sonaliNautiyal/Temperature-Logger-IoT/documents/program explained/Program flow.pptx

## Program

Explain

## Flow Chart

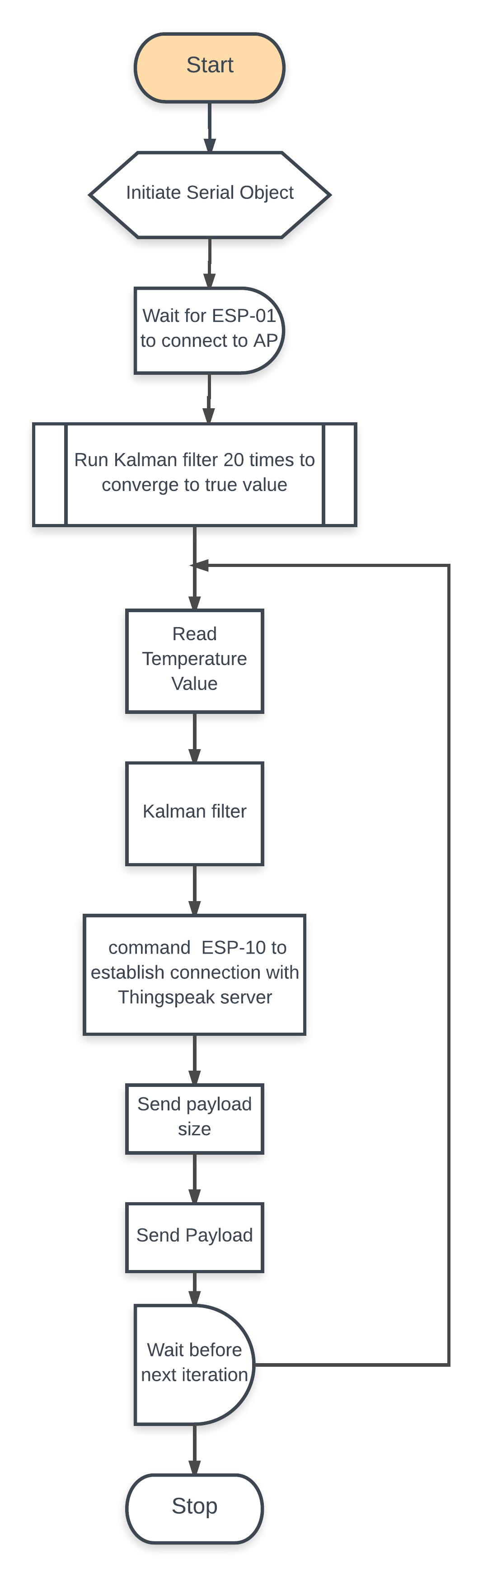
[picture p1: figure]

## Code

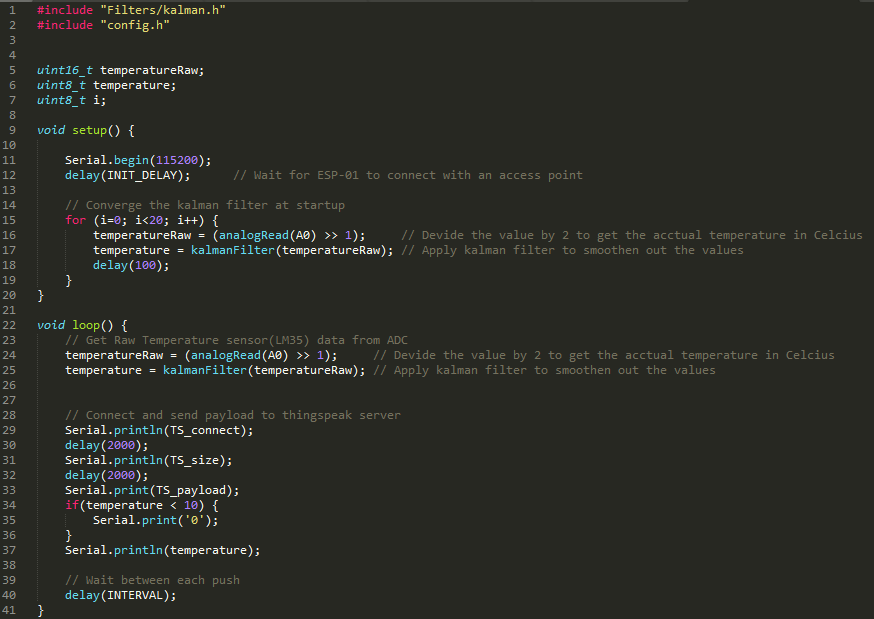
[picture p2: figure]

## config.h

Establish Connection with
Thingspeak Server

Payload without the temp. value

Declare Payload size (i.e. 74 bytes)

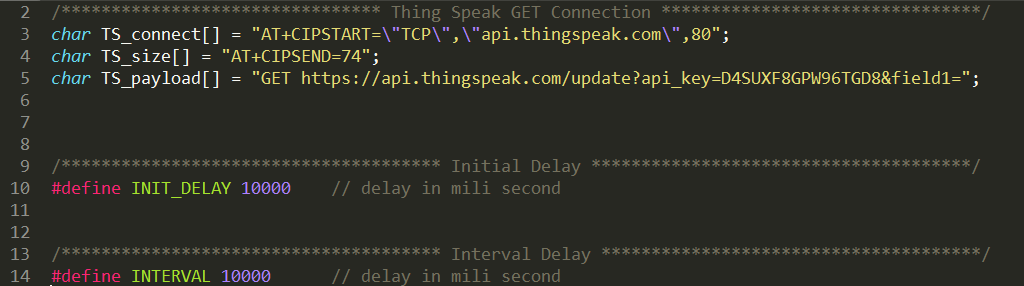
[picture p3: figure]

Chanel Key
