sonaliNautiyal/Temperature-Logger-IoT/documents/report/Report - IoT Temperature Sensor.pdf

## IoT Temperature Sensor

The aim was to design a device that can sense temperature of the environment and can periodically upload temperature data to a server on a cloud.

Few features of the device should be:

- Small
- Powered with lithium polymer cell
- Energy efficient
- WiFi Enabled

Components Used:

- TP4056 Module for LIPO battery charging and protection
- ATmega328P – AU (TQFP package for smaller size)
- Boost Converter of 5VDC output
- AMS1117 IC (3.3V linier voltage regulator for WiFi module)
- ESP-01 (ESP8266 based WiFi module)
- LM35 – Temperature sensor
- Lithium Polymer battery (1s)

Schematic Design (In Eagle PCB):

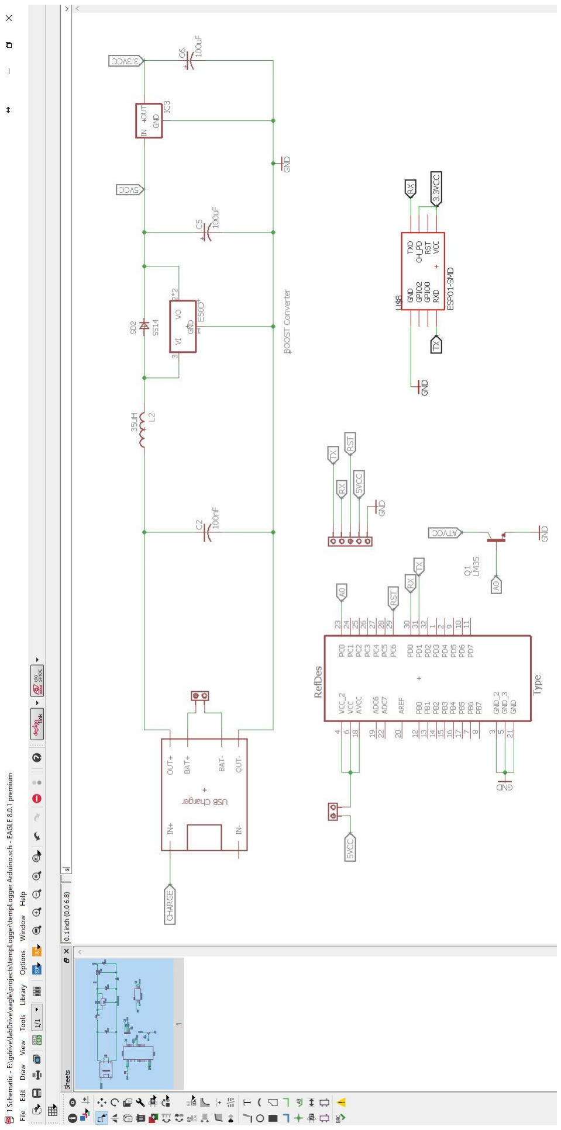
[picture p4: figure]
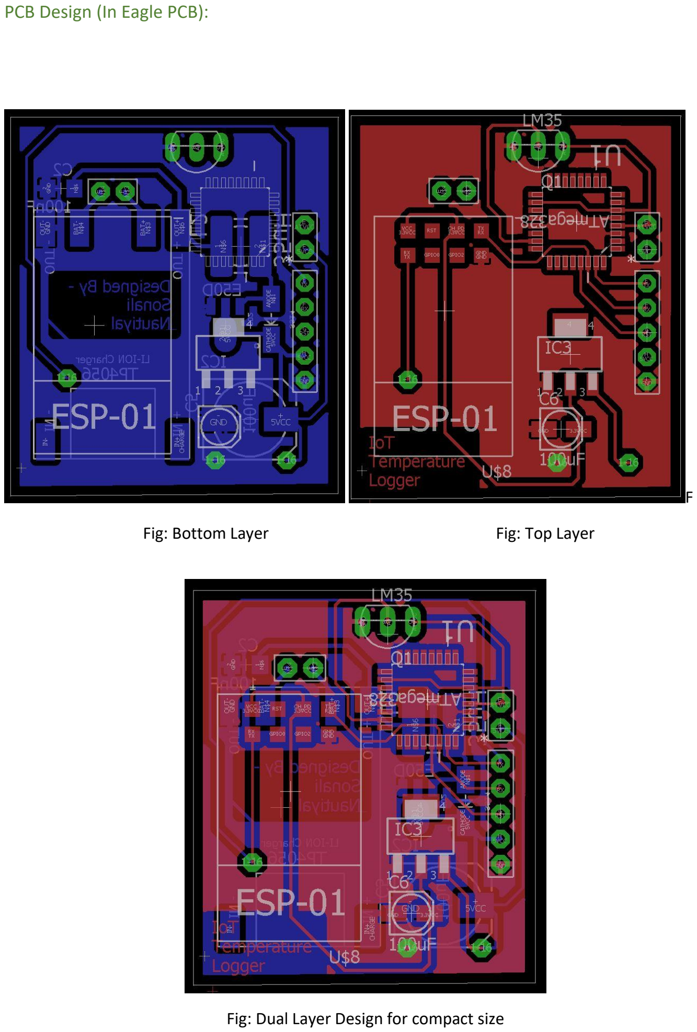
[picture p5: page 3]

PCB Design (In Eagle PCB):

F

Fig: Bottom Layer | Fig: Top Layer

Fig: Dual Layer Design for compact size

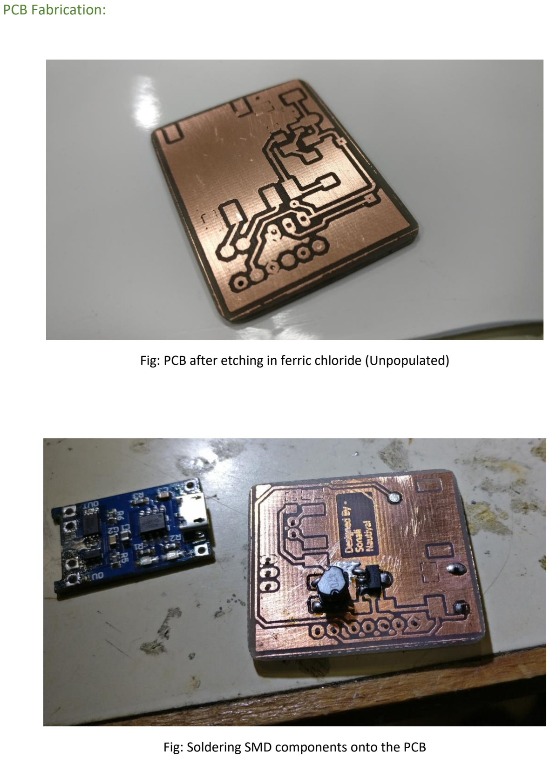
[picture p6: page 4]

PCB Fabrication:

Fig: PCB after etching in ferric chloride (Unpopulated)

Fig: Soldering SMD components onto the PCB

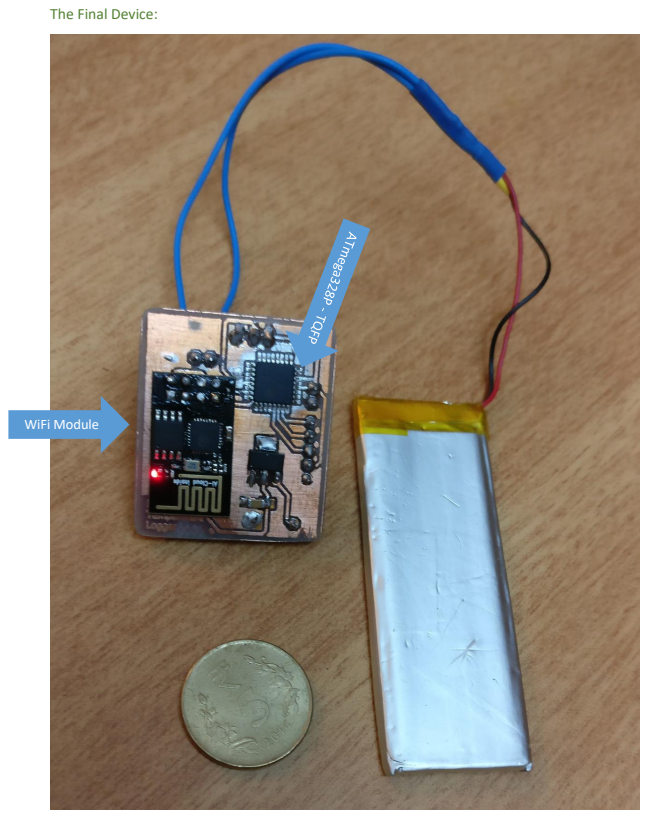
[picture p7: page 5]
WiFi Module

The Final Device:

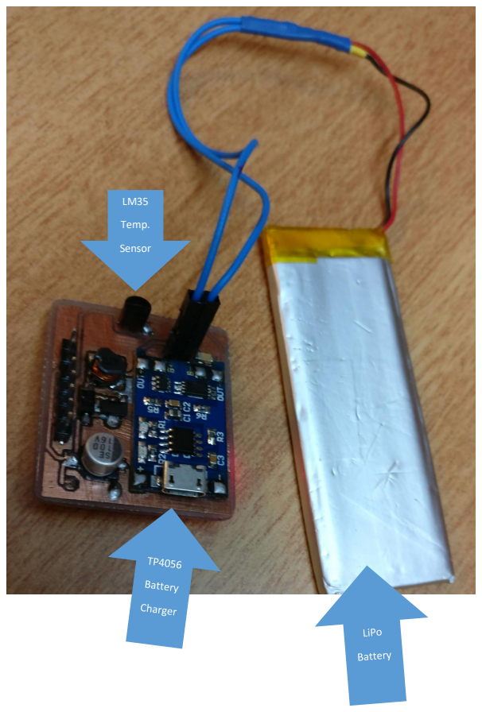
[picture p8: page 6]
Temp.; Sensor

Could Access:

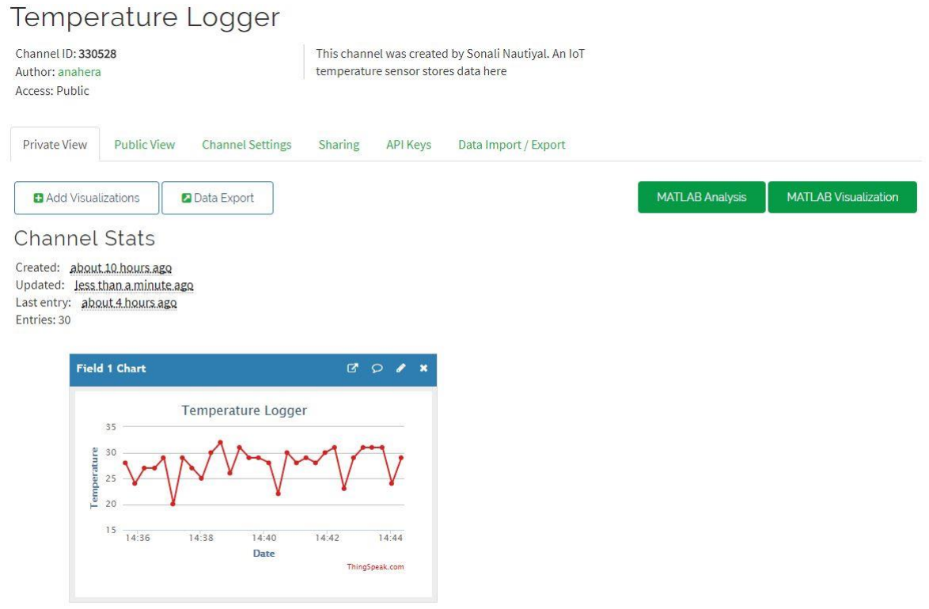
[picture p9: figure]

Fig: Accessing real-time temperature data stored in could server

Public Access Link:

## https://thingspeak.com/channels/330528
