sonaliNautiyal/Temperature-Logger-IoT/documents/dependency/ESP 8266.pdf

# ESP 8266

Setup

The chip

- ESP 8266 is the most common wifi chip there is
- There are multiple boards that use ESP chips and are as follows

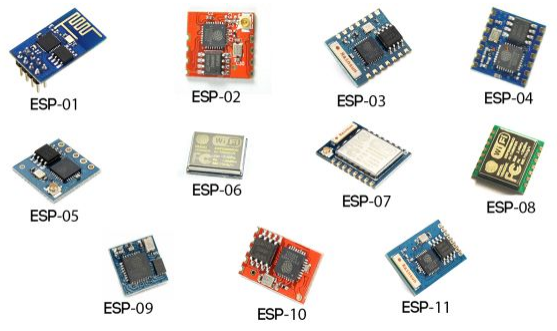
[picture p10: figure]

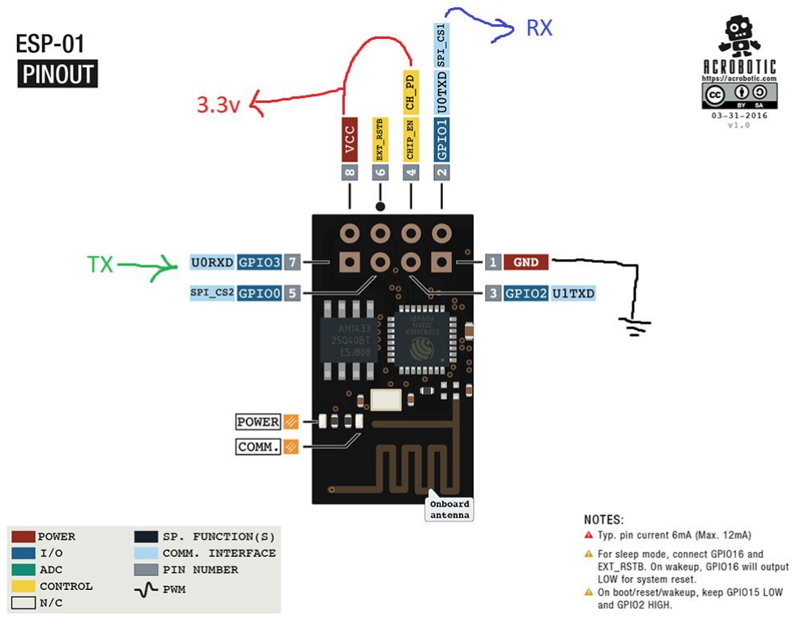
[picture p11: figure]

Pinout and Connections

AT commands in Serial Monitor

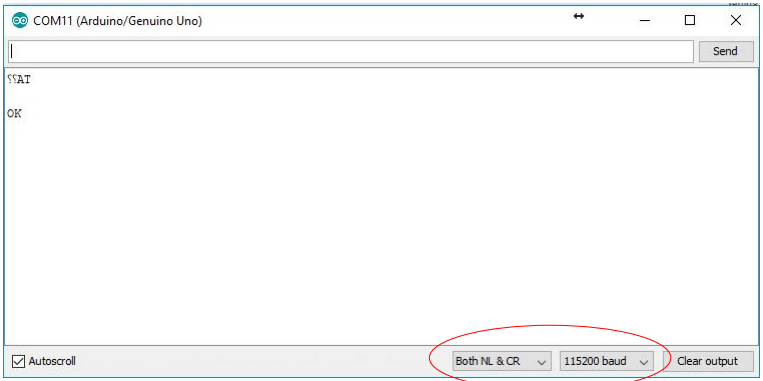
[picture p12: figure]
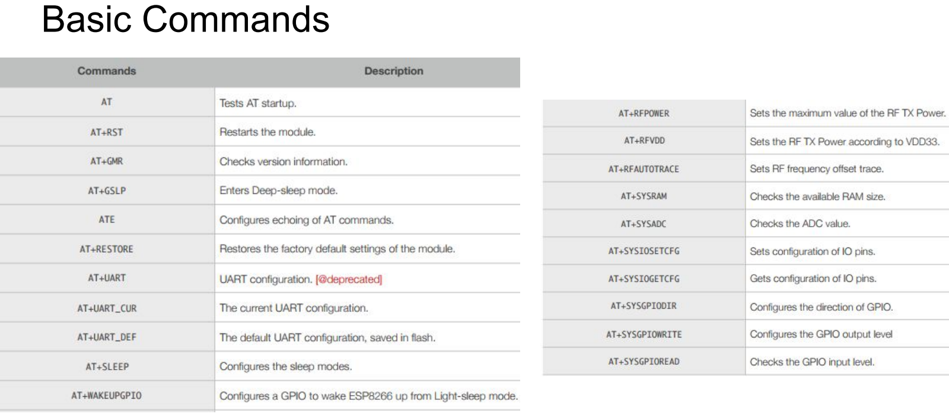
[picture p13: page 5]

Basic Commands

WiFi Commands

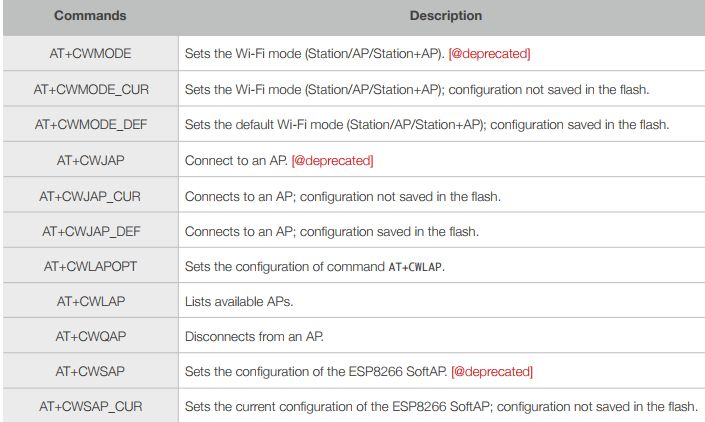
[picture p14: figure]

WiFi Commands

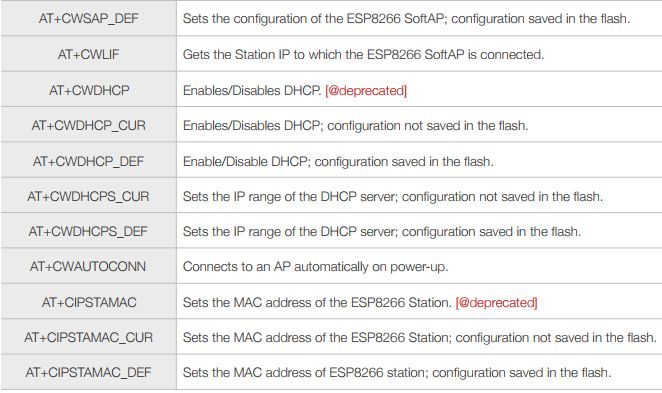
[picture p15: figure]

WiFi Commands

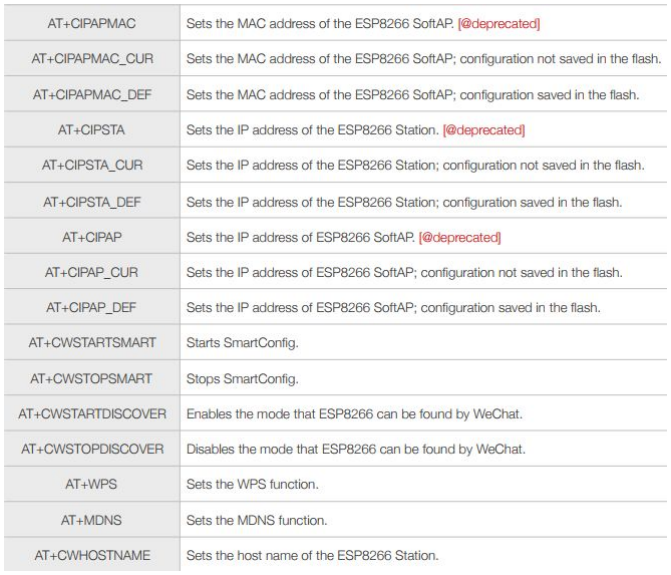
[picture p16: figure]
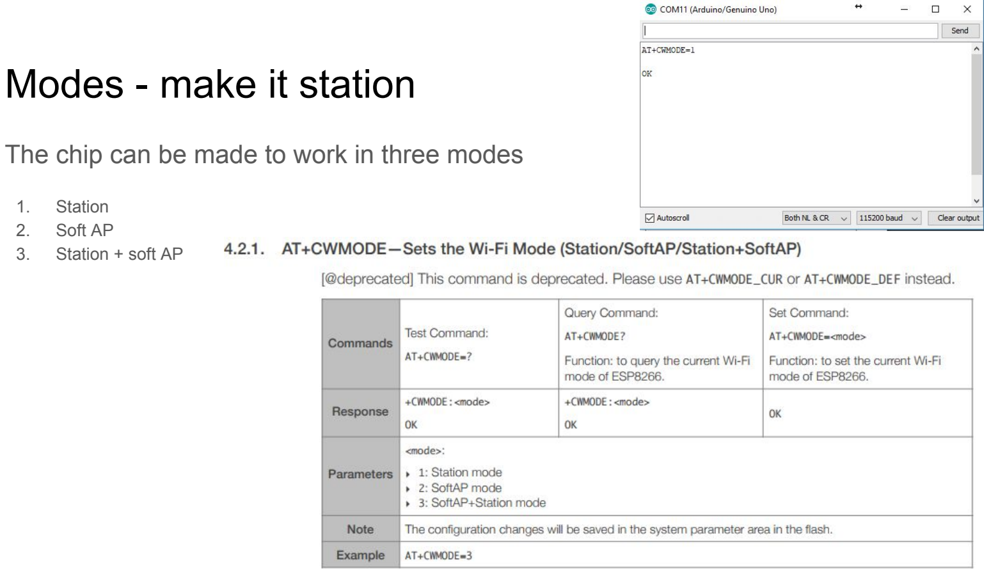
[picture p17: page 9]

Modes - make it station

The chip can be made to work in three modes

1. Station
2. Soft AP
3. Station + soft AP

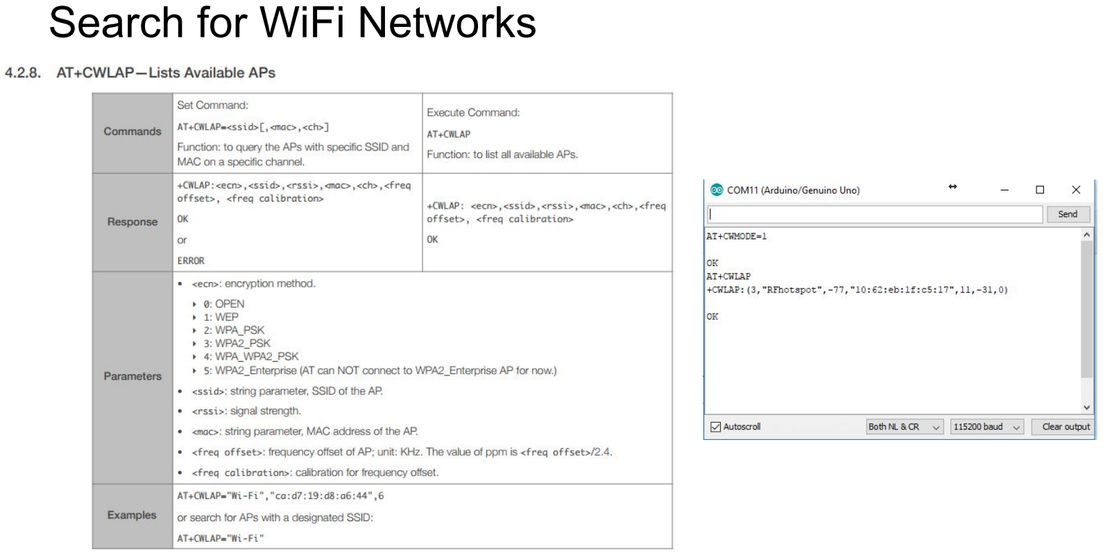
[picture p18: page 10]

Search for WiFi Networks

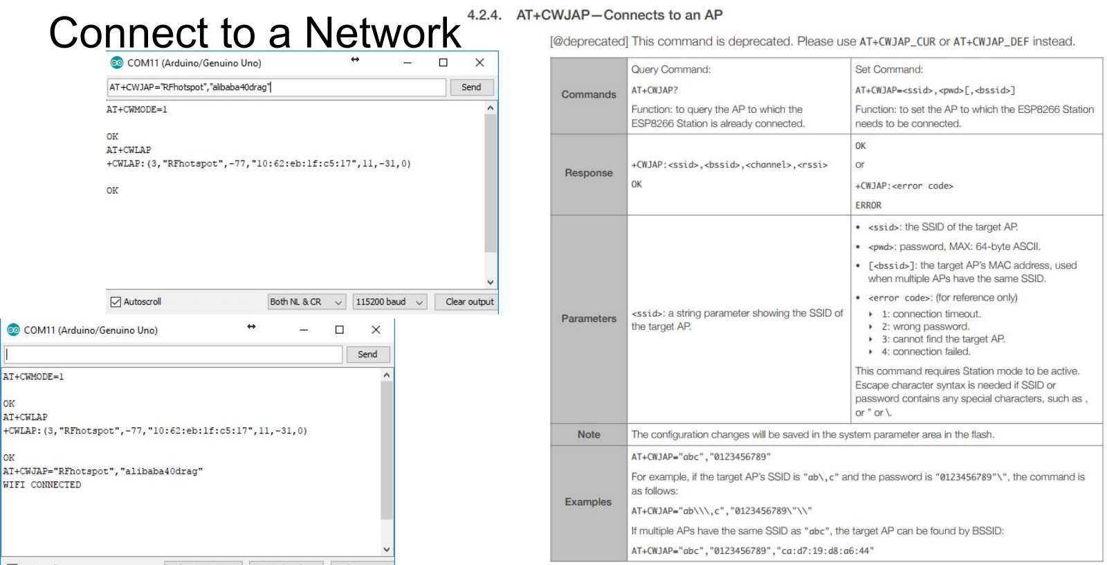
[picture p19: page 11]

Connect to a Network

TCP Commands

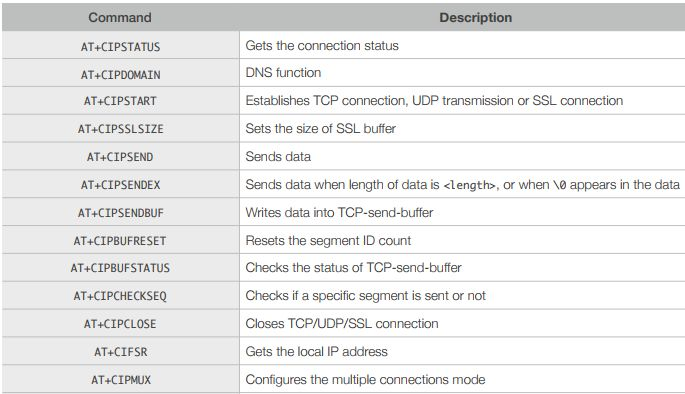
[picture p20: figure]

TCP Commands

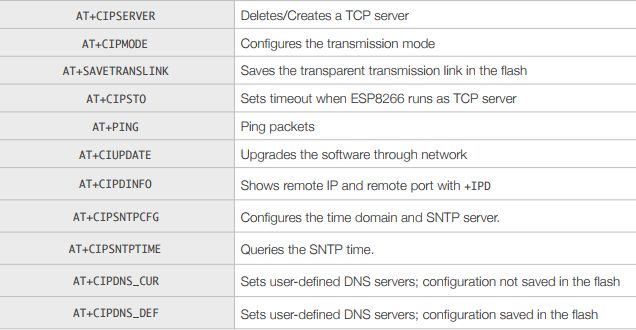
[picture p21: figure]

IoT - Thingspeak.com

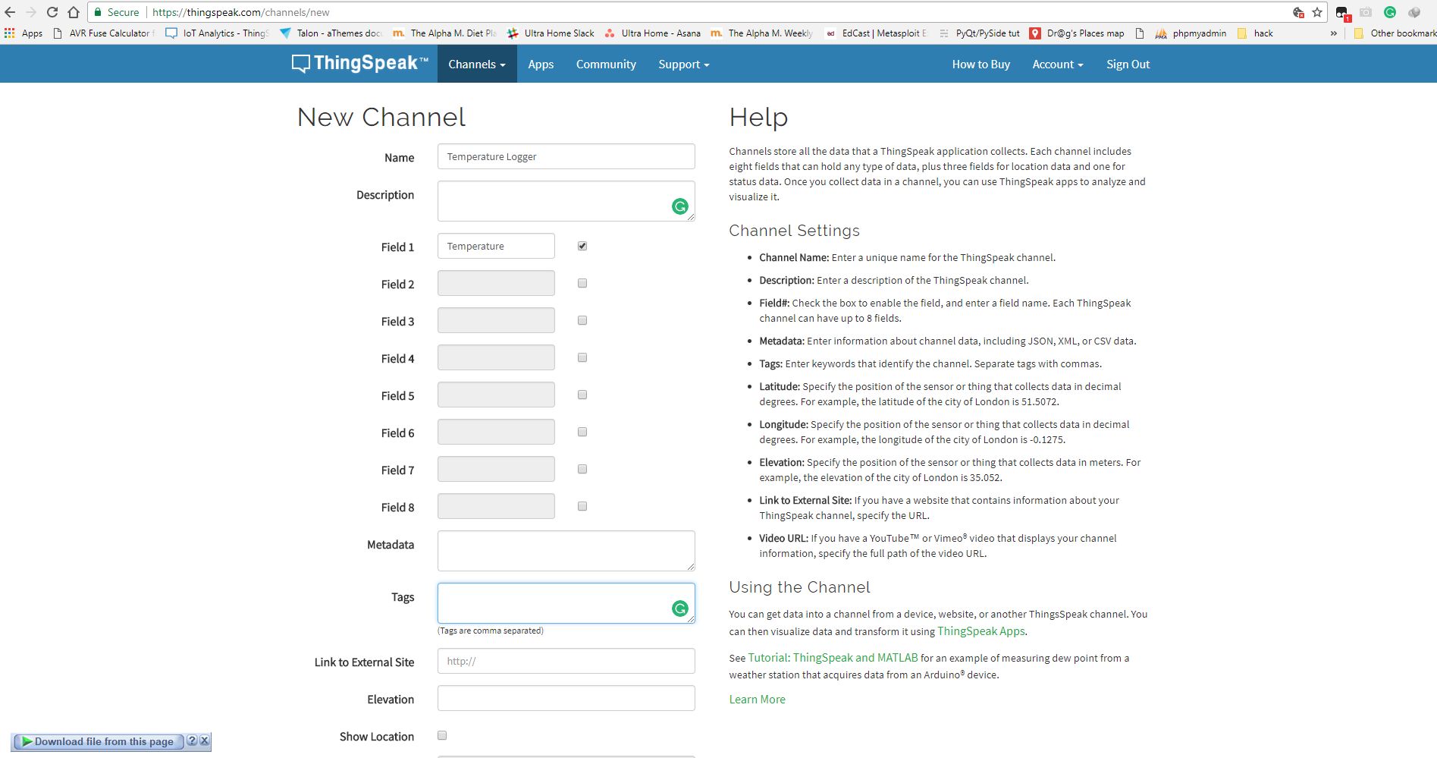
[picture p22: figure]

IoT - Thingspeak.com

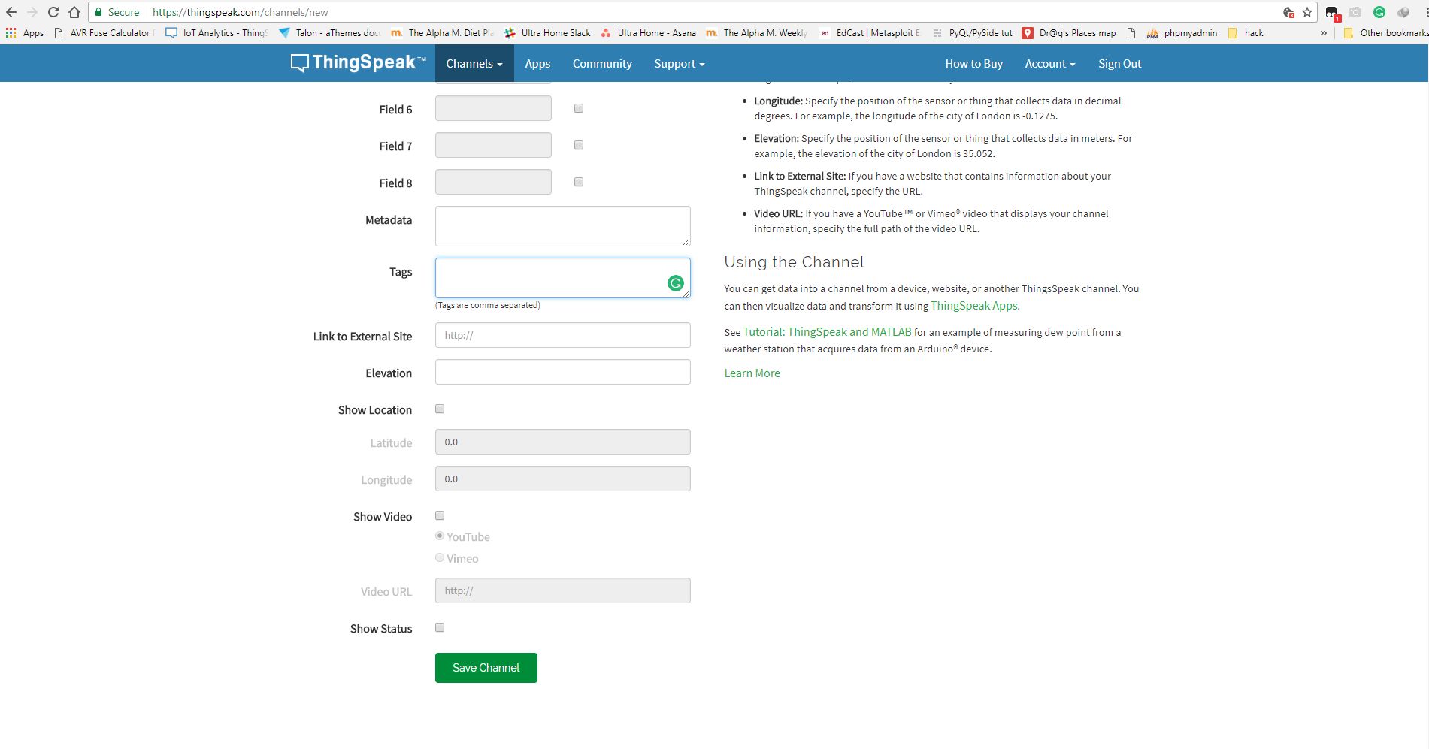
[picture p23: figure]
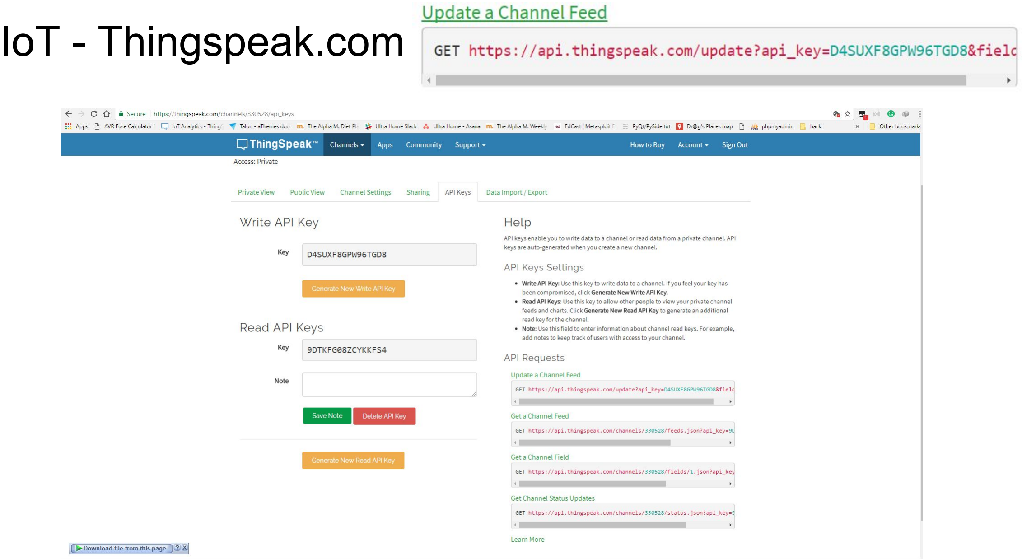
[picture p24: page 16]

IoT - Thingspeak.com

Get Request to Push Data

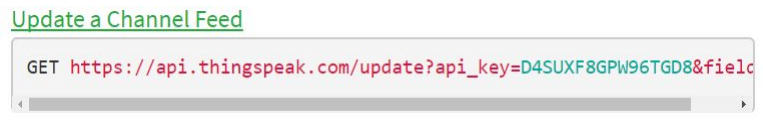
[picture p25: figure]

Value to
be pushed Total number of Bytes in the GET request. Including CR and
LF at the end

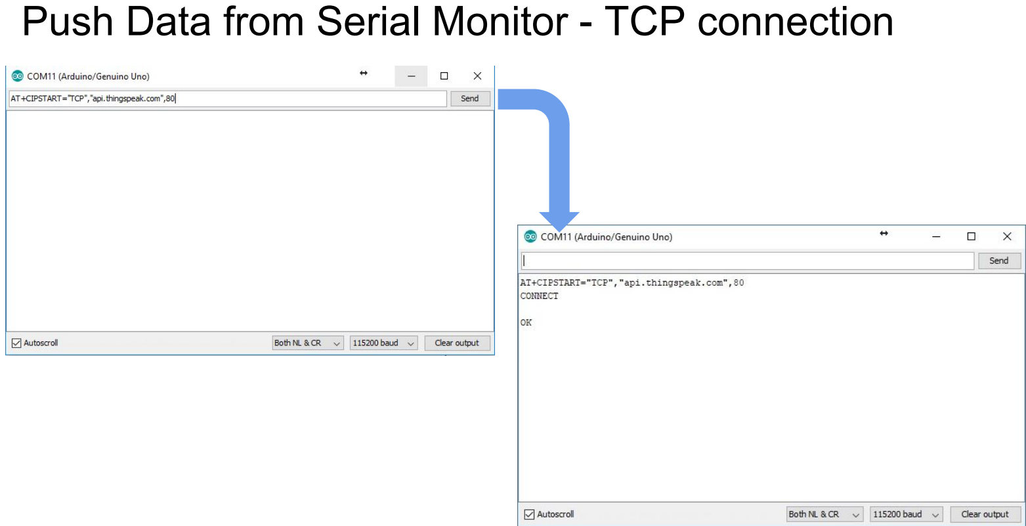
[picture p26: page 18]

Push Data from Serial Monitor - TCP connection

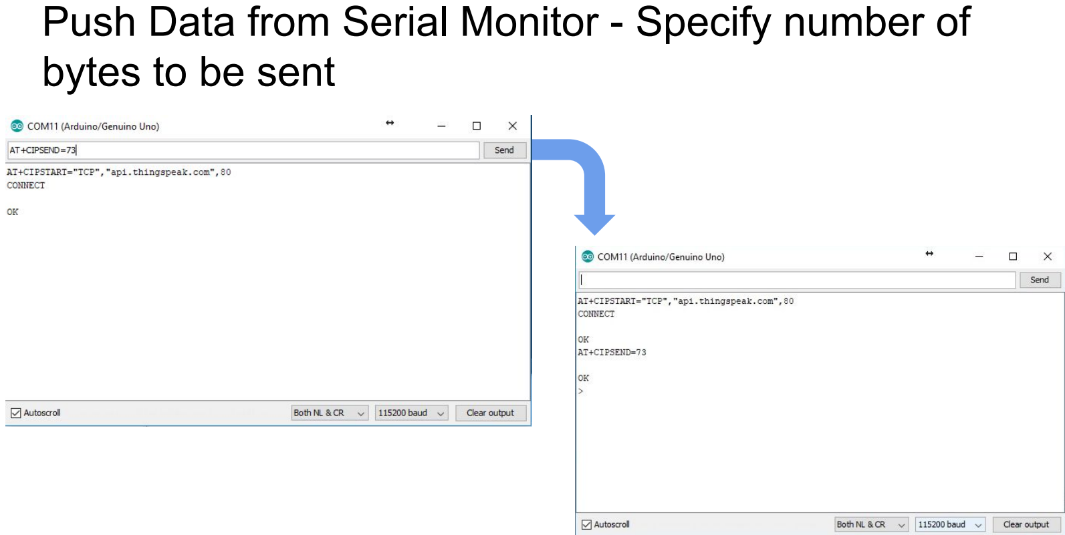
[picture p27: page 19]

Push Data from Serial Monitor - Specify number of bytes to be sent

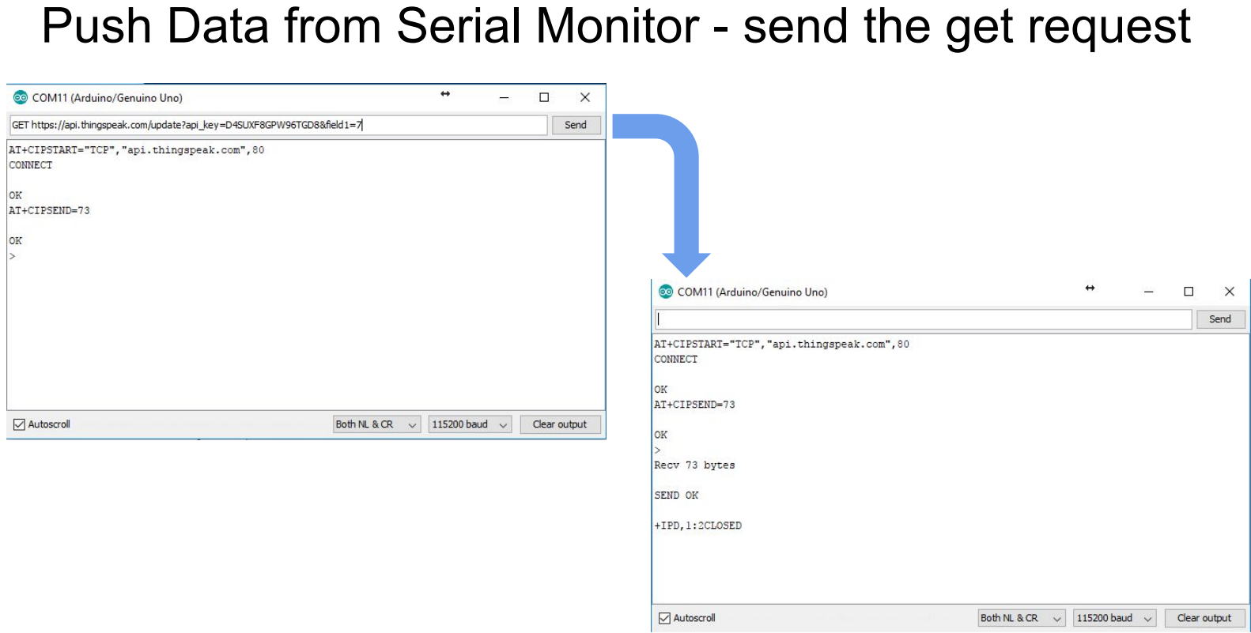
[picture p28: page 20]

Push Data from Serial Monitor - send the get request

Visualize the data

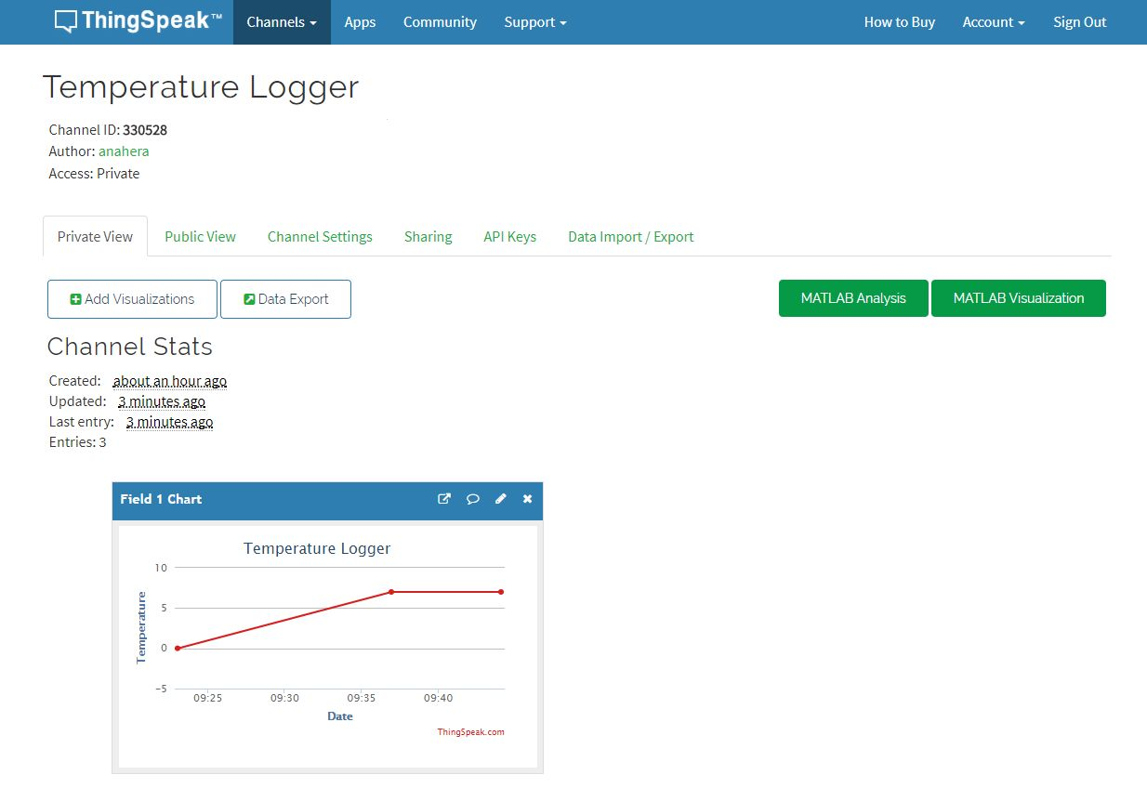
[picture p29: figure]
