sonaliNautiyal/Temperature-Logger-IoT/documents/board explained/Manual.pdf

# IoT - Temperature Logger

# Block Diagram

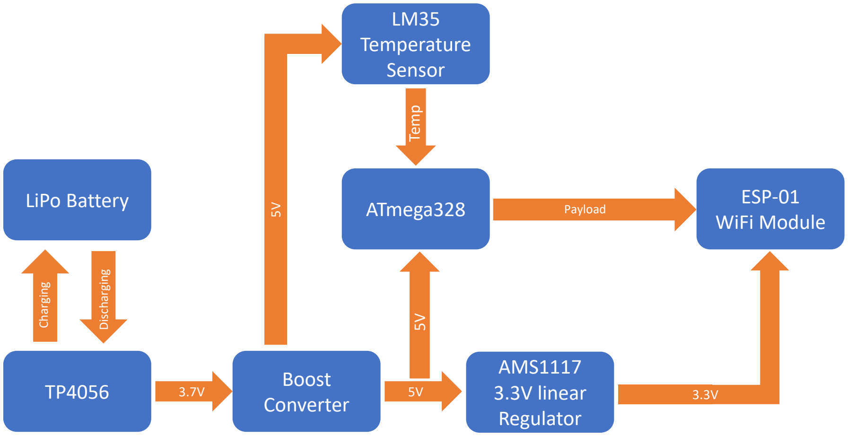
[picture p30: figure]
LiPo Battery Charging; Discharging; Boost Converter; AMS1117 3.3V linear Regulator; ATmega328; ESP-01; WiFi Module; LM35 Temperature Sensor; Temp; Payload

Charger

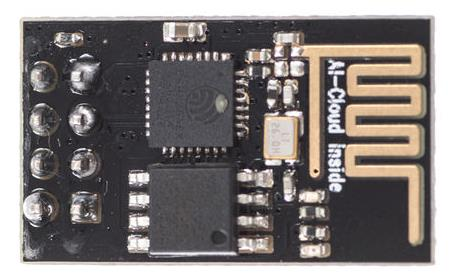
[picture p31: figure]
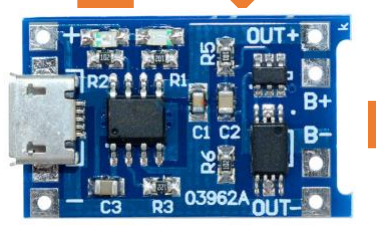
[picture p32: figure]
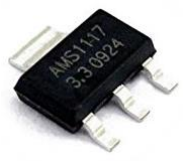
[picture p33: figure]
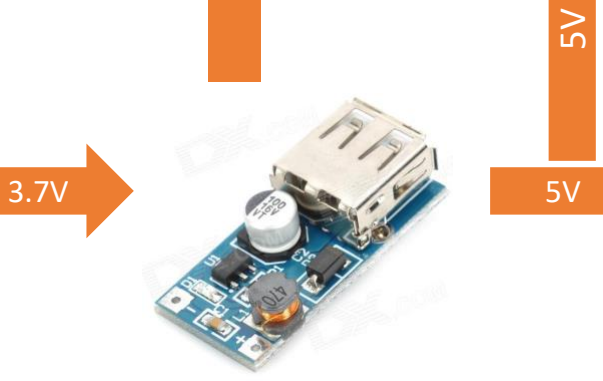
[picture p34: figure]
5V⁵V

3.3V

5V

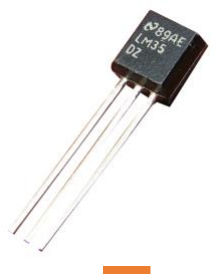
[picture p35: figure]

Temp

Payload

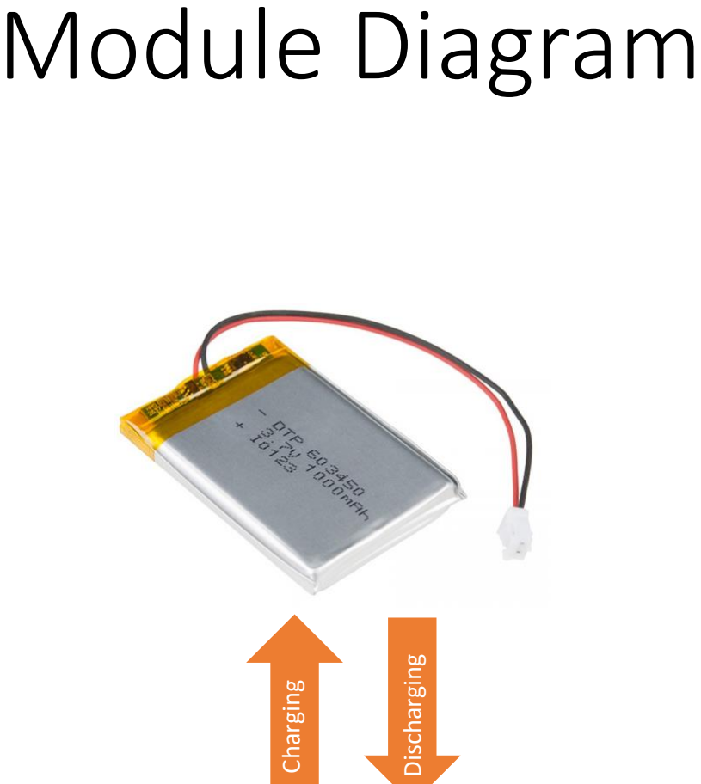
[picture p36: figure]
Module Diagram Charging; Discharging

Charger

# Board Layout op

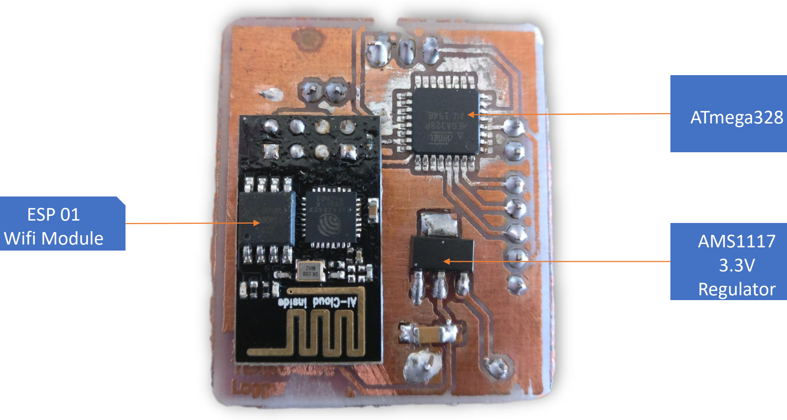
[picture p37: figure]
Wifi Module; AMS1117; 3.3V Regulator; ATmega328

ESP 01

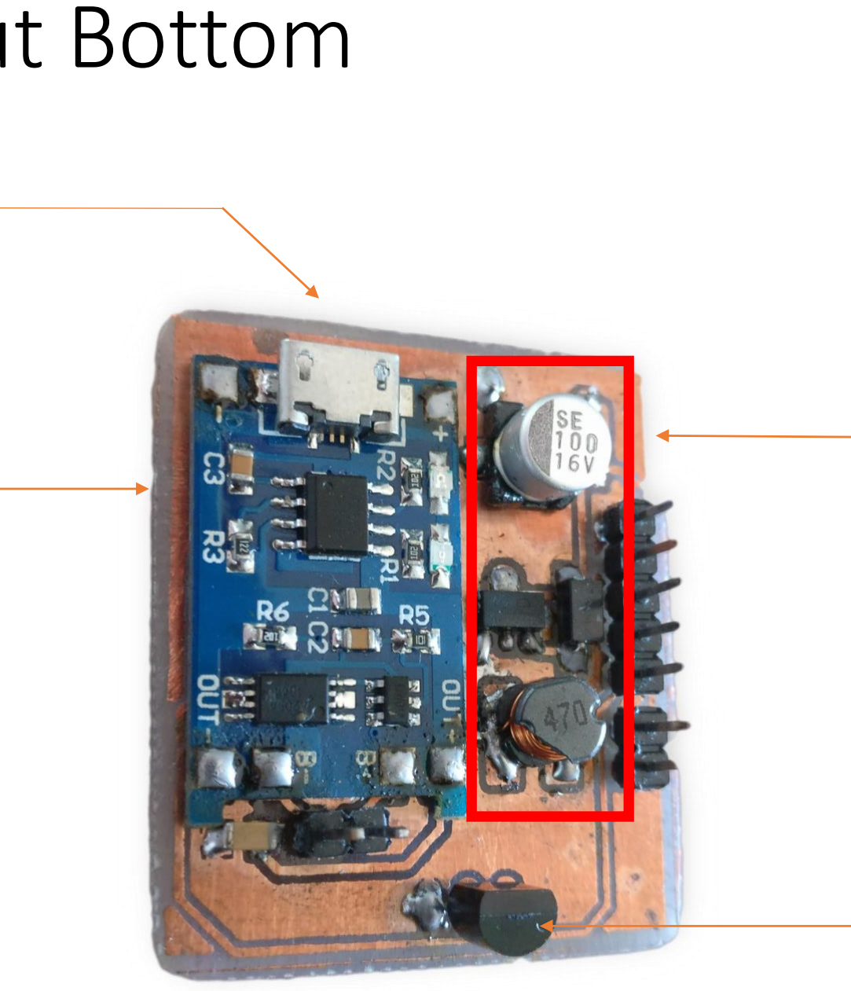
[picture p38: figure]

# Board Layout Bottom

External
Charger

TP4056
Module

LM35
Temperature
Sensor

Boost
Converter

# Board Pinout op

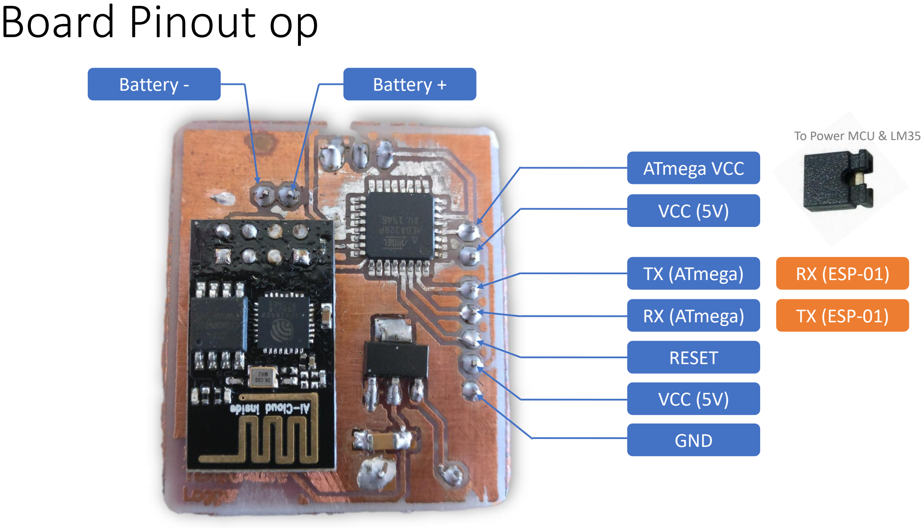
[picture p39: page 6]

Battery +

TX (ATmega)

RX (ATmega)

RESET

VCC (5V)

GND

ATmega VCC

RX (ESP-01)

TX (ESP-01)

To Power MCU & LM35

VCC (5V)

Battery -

# Board Pinout Bottom

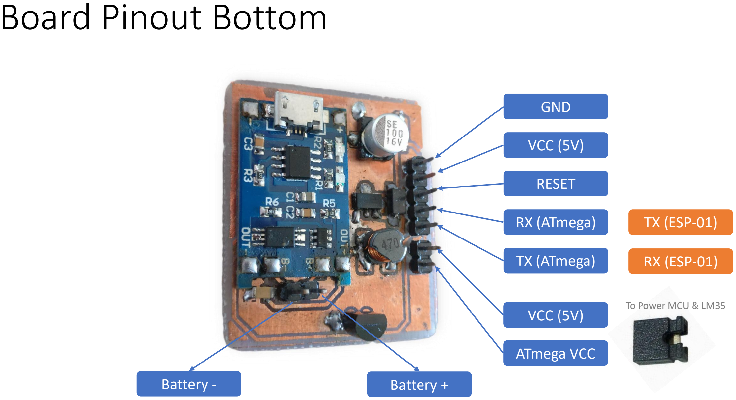
[picture p40: page 7]

TX (ATmega)

RX (ATmega)

RESET

VCC (5V)

GND

VCC (5V)

RX (ESP-01)

TX (ESP-01)

To Power MCU & LM35

ATmega VCC

Battery - | Battery +

# Program The ATmega328

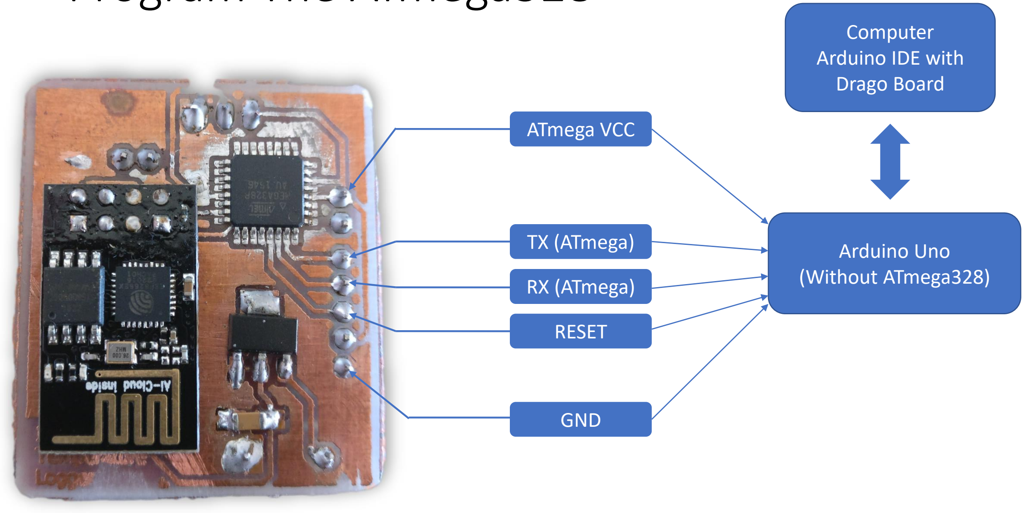
[picture p41: figure]
TX (ATmega); RX (ATmega); RESET; GND; ATmega VCC; Arduino Uno (Without ATmega328); Computer Arduino IDE with Drago Board

# Program The ESP-01

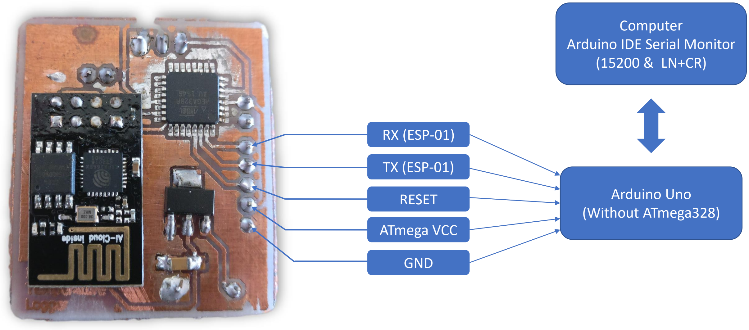
[picture p42: figure]
RX (ESP-01); TX (ESP-01); RESET; GND; ATmega VCC; Arduino Uno (Without ATmega328); Computer Arduino IDE Serial Monitor (15200 & LN+CR)

# Normal Operation

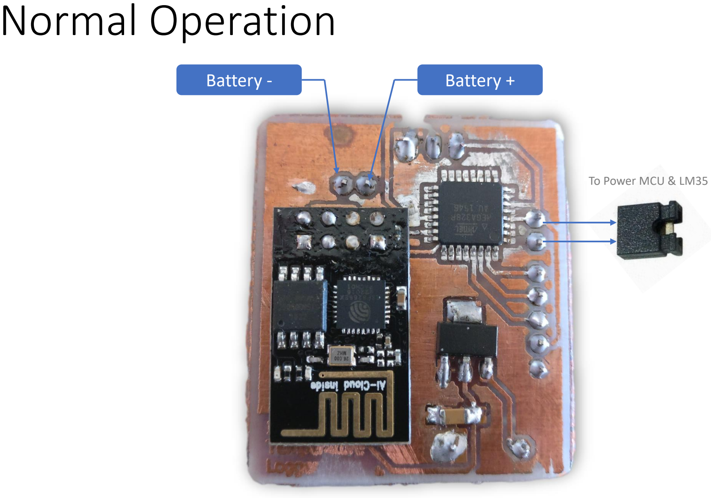
[picture p43: page 10]

Battery +

To Power MCU & LM35

Battery -
