sonaliNautiyal/Temperature-Logger-IoT/documents/eagle printables/IoT temperature logger board bottom.pdf

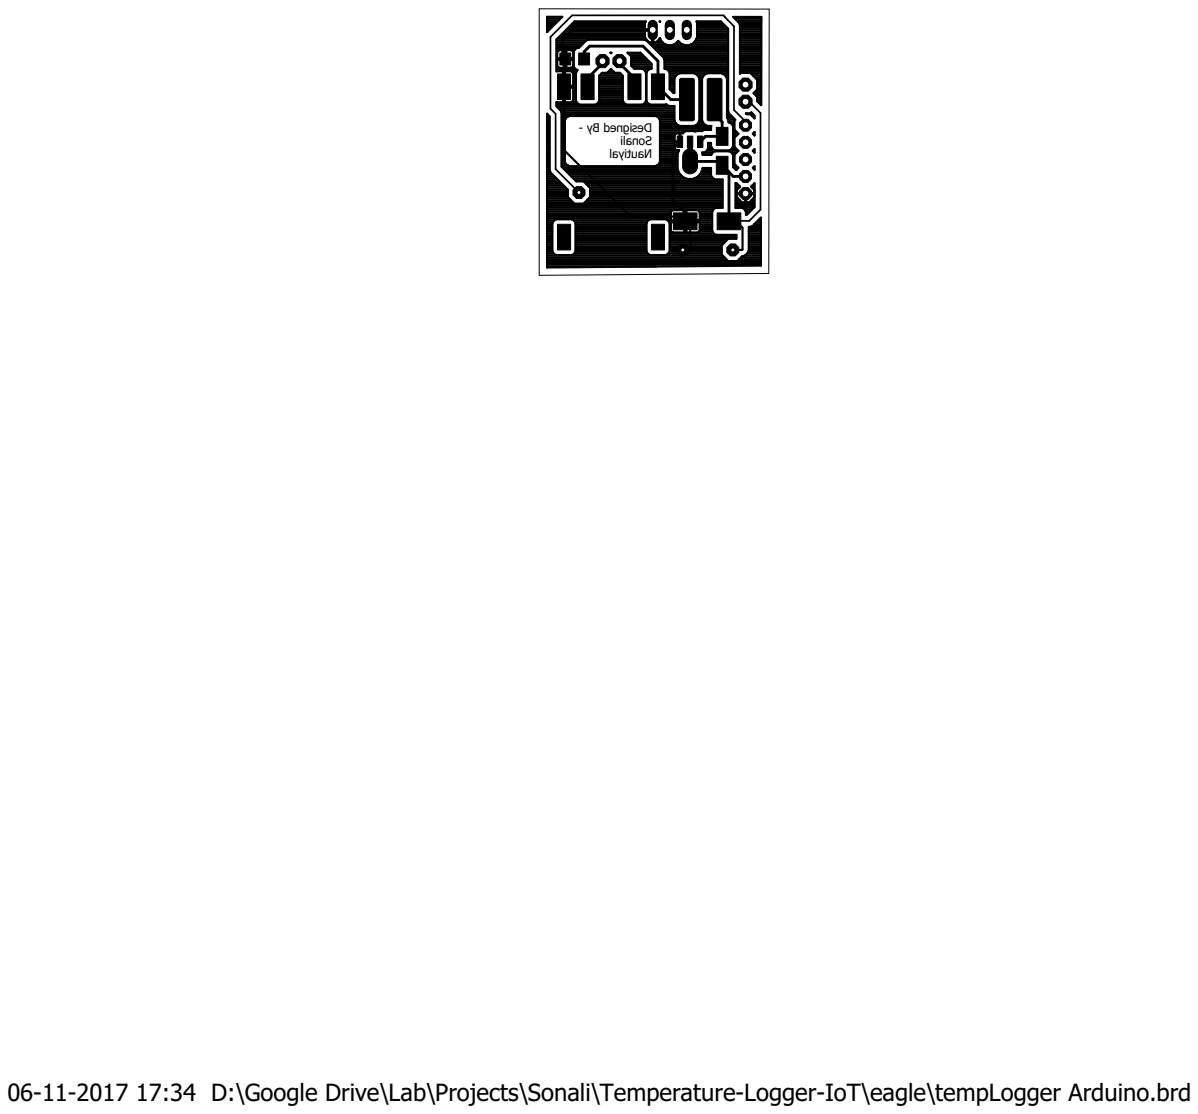
[picture p44: page 1]

06-11-2017 17:34 D:\Google Drive\Lab\Projects\Sonali\Temperature-Logger-IoT\eagle\tempLogger Arduino.brd
