sonaliNautiyal/Temperature-Logger-IoT/documents/eagle printables/IoT temperature logger board top.pdf

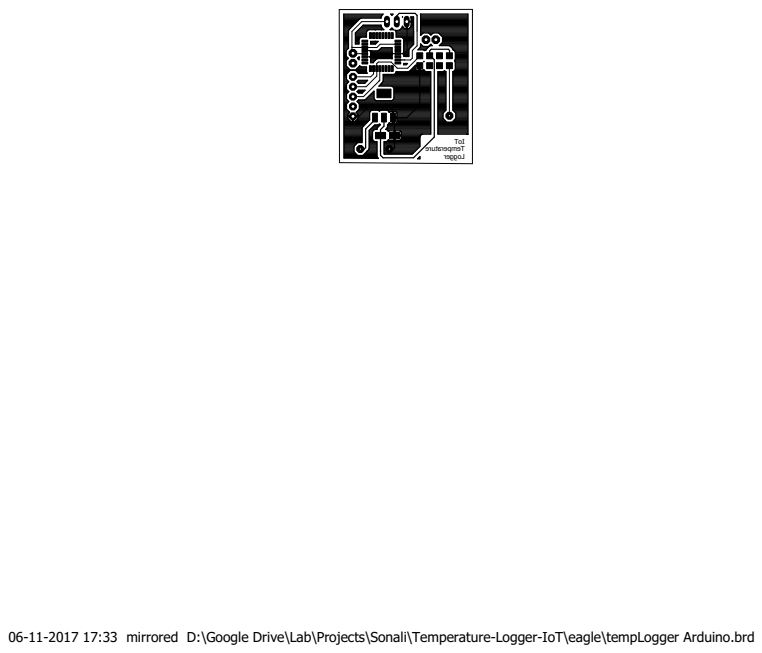
[picture p45: page 1]

06-11-2017 17:33 mirrored D:\Google Drive\Lab\Projects\Sonali\Temperature-Logger-IoT\eagle\tempLogger Arduino.brd
