sonaliNautiyal/Temperature-Logger-IoT/eagle/tempLogger Arduino.brd

## EAGLE design eagle/tempLogger Arduino.brd (2017-11-05)

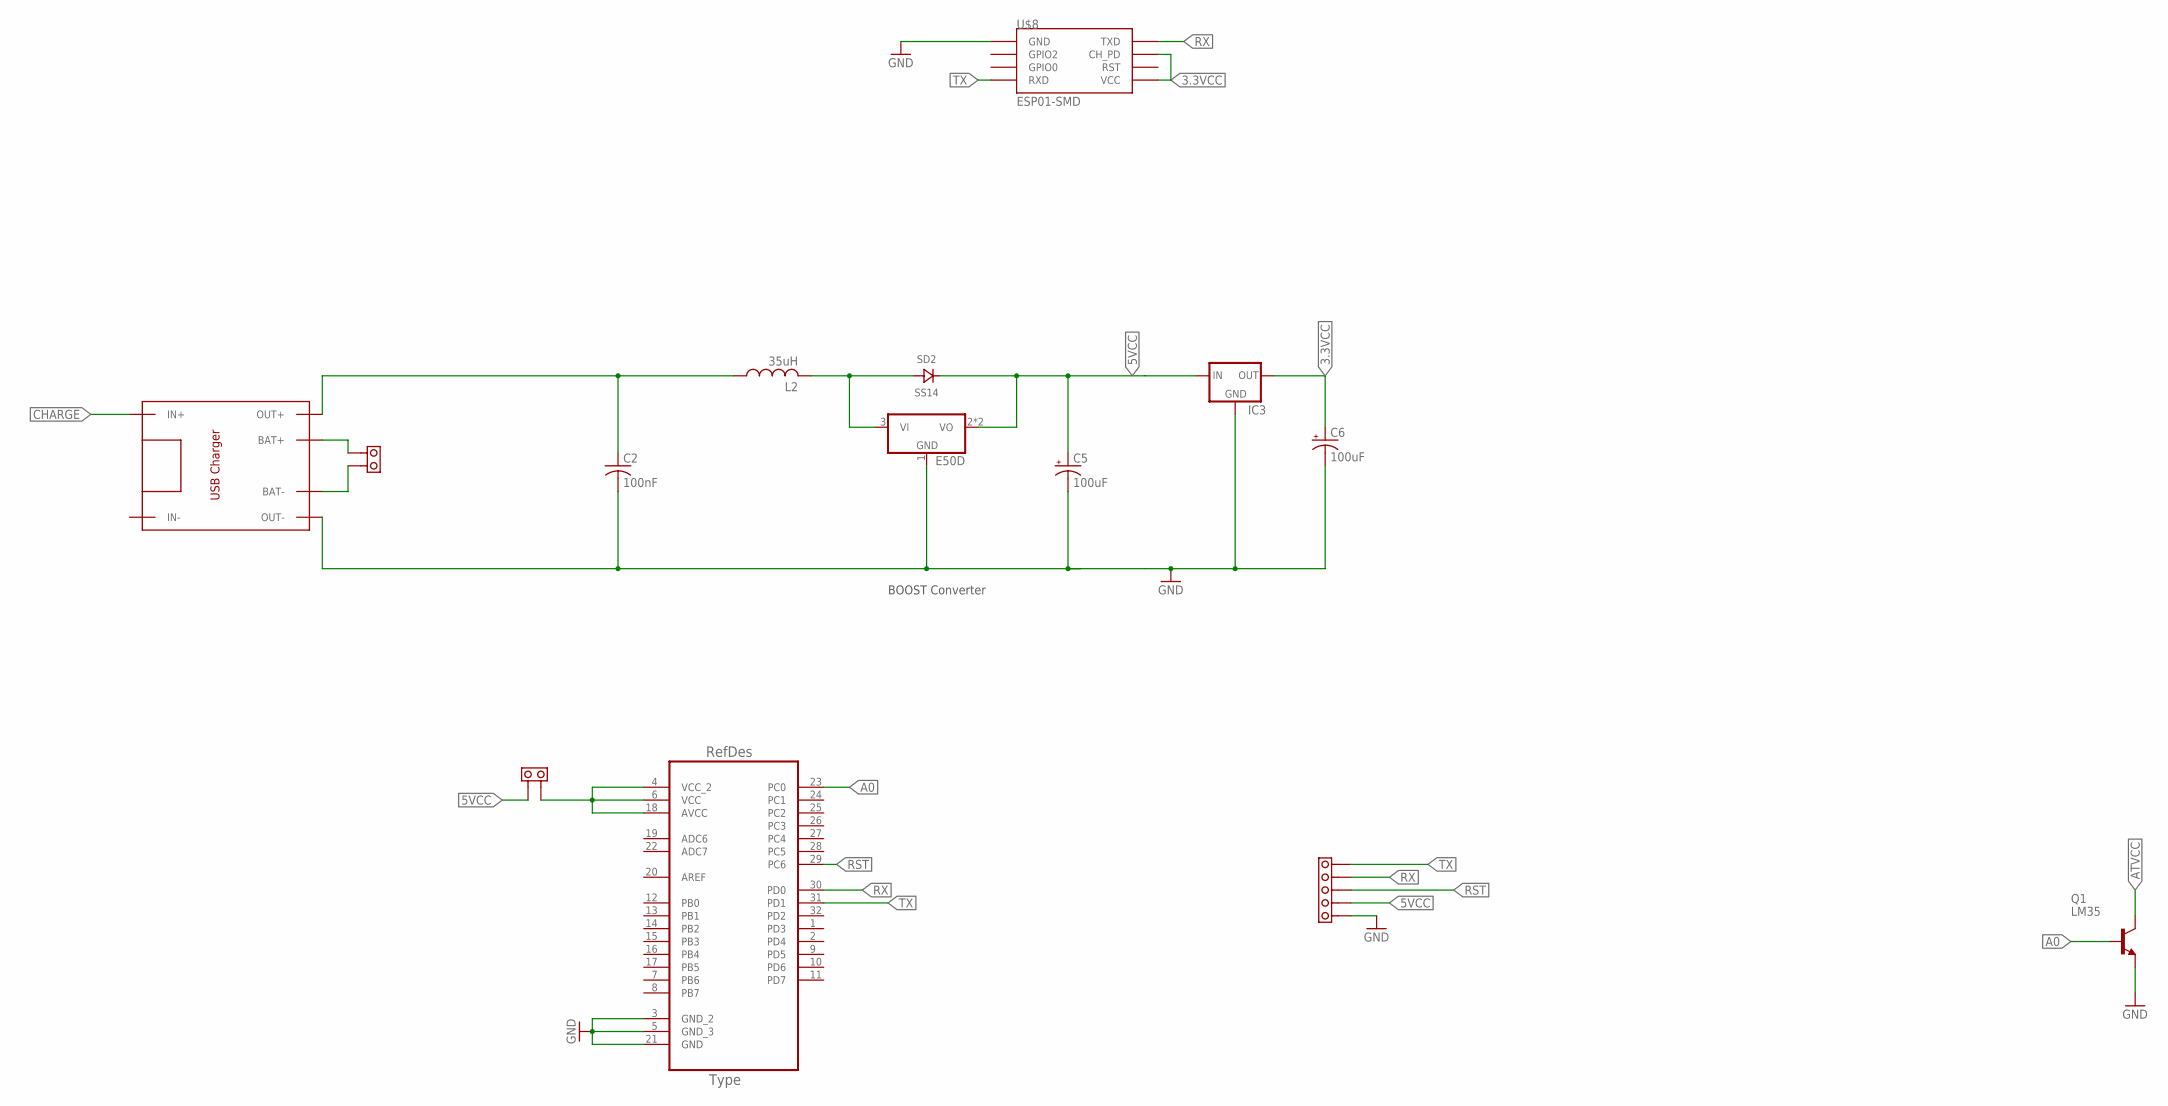
[picture p46: schematic tempLogger Arduino.sch]

Parts:
C2: 100nF; C1206
C5: 100uF; 150CLZ-0810
C6: 100uF; 153CLV-0405
IC2: E50D; SOT89
IC3: LM1117; SOT223
L2: 35uH; POWER-CHOKE_WE-TPC
Q1: LM35; TO92-EBC
SD2: SS14; DO214
U1: ATMEGA328P-AU; QFP80P900X900X120-32N
U$2: TP4056
U$3: BERG_5
U$4, U$5: BERG_2
U$8: ESP01-SMD; ESP01_SMD

Connections:
3.3VCC: C6.+, IC3.2 (OUT), U$8.CH_PD, U$8.VCC
5VCC: C5.+, IC2.2 (VO), IC2.2@1 (VO), IC3.3 (IN), SD2.CATHODE, U$3.H, U$5.F
A0: Q1.B, U1.23 (PC0)
ATVCC: Q1.C, U1.4 (VCC_2), U1.6 (VCC), U1.18 (AVCC), U$5.E
CHARGE: U$2.IN+
GND: C2.2, C5.-, C6.-, IC2.1 (GND), IC3.1 (GND), Q1.E, U1.3 (GND_2), U1.5 (GND_3), U1.21 (GND), U$2.OUT-, U$3.I, U$8.GND
unnamed: IC2.3 (VI), L2.2, SD2.ANODE
unnamed: U$2.BAT+, U$4.F
unnamed: U$2.BAT-, U$4.E
unnamed: C2.1, L2.1, U$2.OUT+
RST: U1.29 (PC6), U$3.G
RX: U1.30 (PD0), U$3.F, U$8.TX (TXD)
TX: U1.31 (PD1), U$3.E, U$8.RX (RXD)

Notes on the sheet:
BOOST Converter

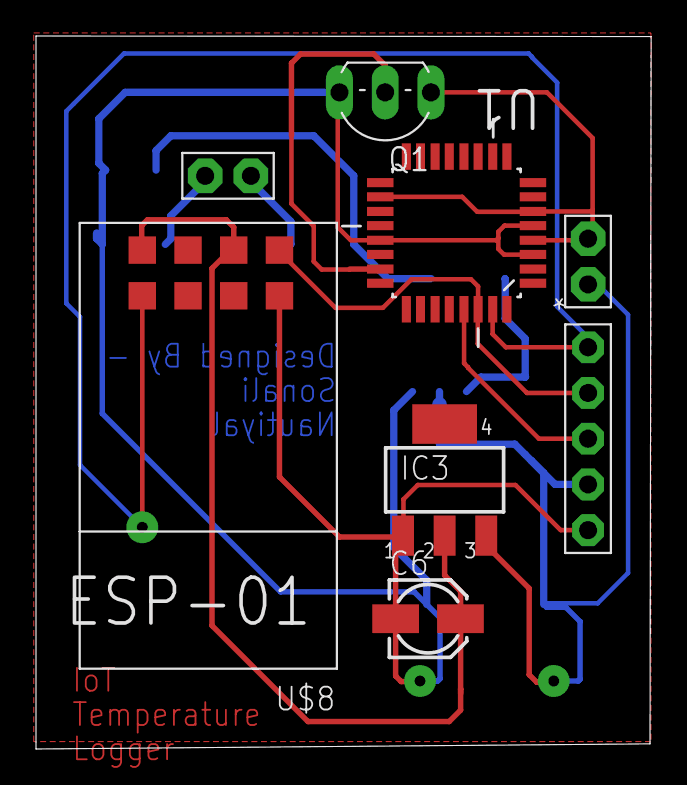
[picture p47: board tempLogger Arduino.brd from above]

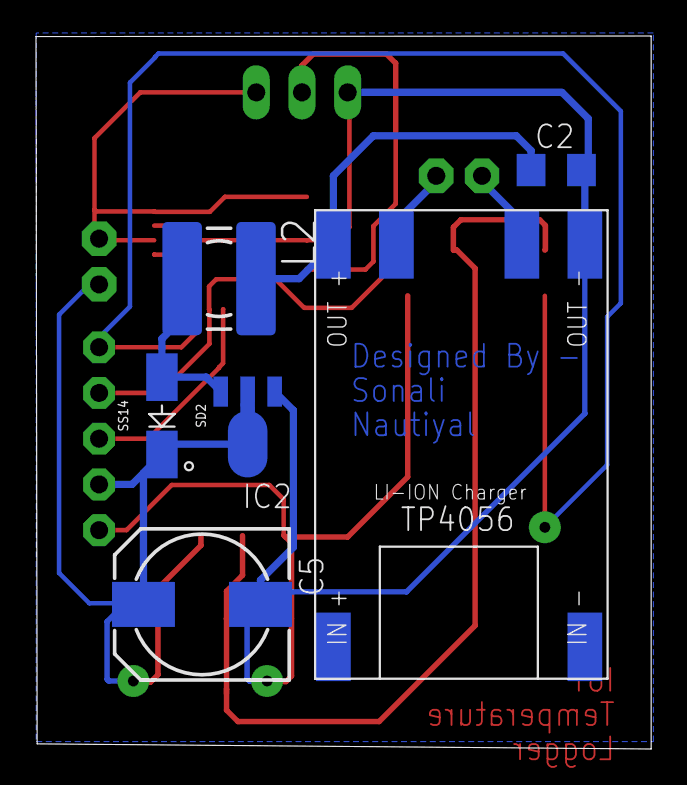
[picture p48: board tempLogger Arduino.brd from below]

Board: 2 copper layers, 34.2 x 39.6 mm, 14 parts (6 on the bottom side), 12 nets.
