sonaliNautiyal/Temperature-Logger-IoT/(commit log)

2017-10-02 ADD: Initial adding of all files
    [tempLogger Arduino.brd, tempLogger Arduino.sch, tempLogger.brd, tempLogger.sch]
2017-11-05 ADD: Arduino Code UPDATE: Restructure the files
    [tempLogger Arduino.brd, tempLogger Arduino.sch, tempLogger.brd, tempLogger.sch]
